Biacco42/meishi2/biacco42_2020.png

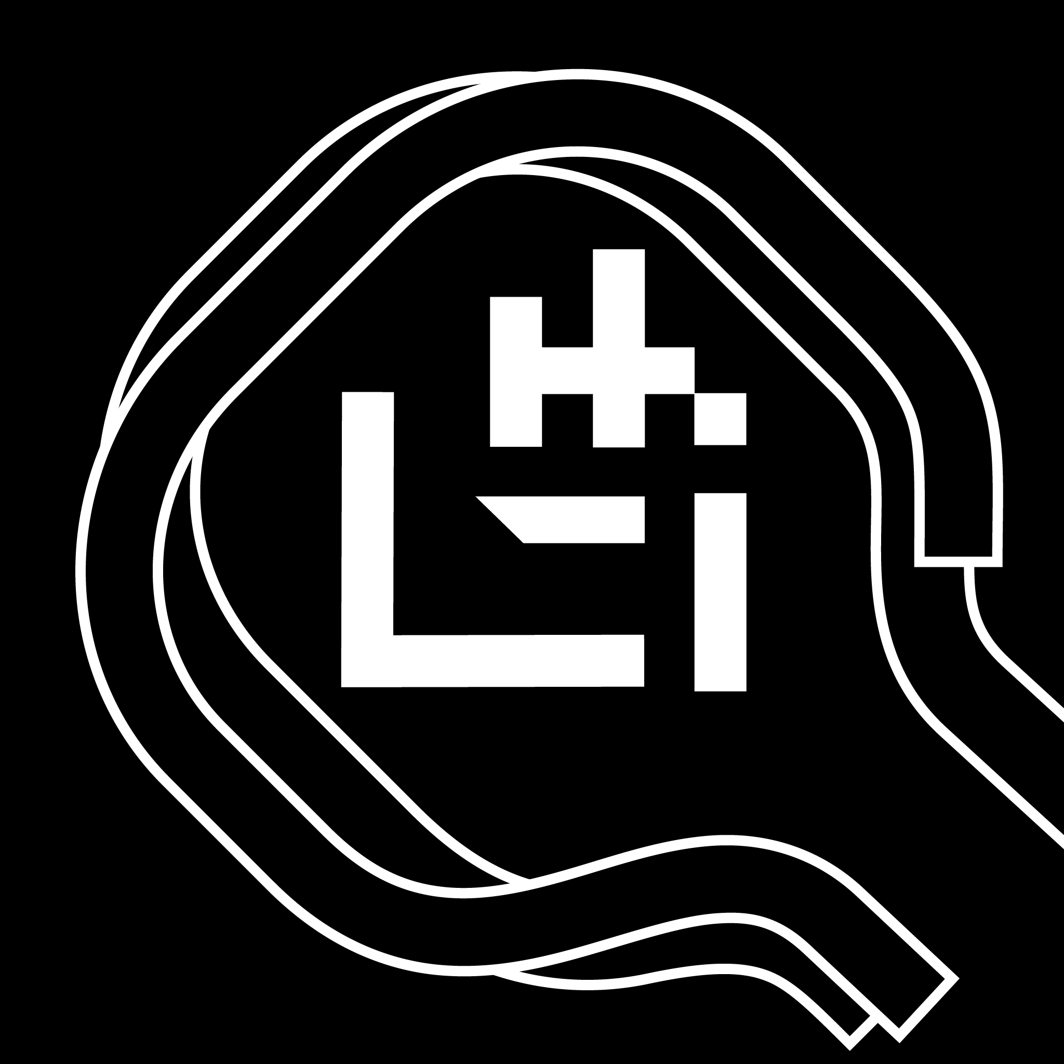
biacco42_2020.png
