Biacco42/meishi2/(commit log)

2019-05-16 Update the diode footprint and the screwhole
    [meishi2-B.Cu.gbl, meishi2-B.Mask.gbs, meishi2-B.Paste.gbp, meishi2-B.SilkS.gbo, meishi2-Edge.Cuts.gm1, meishi2-F.Cu.gtl, meishi2-F.Mask.gts, meishi2-F.Paste.gtp]
2019-05-16 Fix some silk
    [meishi2-B.Cu.gbl, meishi2-B.Mask.gbs, meishi2-B.Paste.gbp, meishi2-B.SilkS.gbo, meishi2-Edge.Cuts.gm1, meishi2-F.Cu.gtl, meishi2-F.Mask.gts, meishi2-F.Paste.gtp]
2019-05-16 Update credit silk
    [meishi2-B.Cu.gbl, meishi2-B.Mask.gbs, meishi2-B.Paste.gbp, meishi2-B.SilkS.gbo, meishi2-Edge.Cuts.gm1, meishi2-F.Cu.gtl, meishi2-F.Mask.gts, meishi2-F.Paste.gtp]
